slklim/ctm-battery-adapter/README.md

# ctm-battery-adapter
Hardware solution to replace two AAA batteries used to power a handheld CTM device
