slklim/ctm-battery-adapter/hardware/bom/ctm_battery_adapter-BOM_Amazon.xlsx

Line | Qty | Item | Description
1 | 10 | https://www.amazon.com/dp/B08T8TDS8S/ | Miady 2-Pack 5000mAh Mini Portable Charger
2 | 1 | https://www.amazon.com/dp/B018RSXR9C/ | uxcell M3 x 10mm Metric Hex Socket Countersunk Flat Head Screw Bolts 100PCS
