slklim/ctm-battery-adapter/hardware/bom/ctm_battery_adapter-BOM_DigiKey.xlsx

Index | Quantity | Part Number | Manufacturer Part Number | Description | Customer Reference
1 | 20 | 450-1660-ND | 1-1825027-7 | SWITCH TACTILE SPST-NO 0.05A 24V | SW1
2 | 20 | CSR0603FKR500CT-ND | CSR0603FKR500 | RES 0.5 OHM 1% 1/8W 0603 | R2
3 | 20 | 541-IHHP0805ZHER1R0M01CT-ND | IHHP0805ZHER1R0M01 | IHHP-0805ZH-01 1 20% ER E3 | L1
4 | 20 | 541-IHHP0805ZHER2R2M01CT-ND | IHHP0805ZHER2R2M01 | IHHP-0805ZH-01 2.2 20% ER E3 | L2
5 | 20 | A9AAT-0205F-ND | A9AAT-0205F | FLEX CABLE - AFE02T/AF02/AFE02T | J3
6 | 20 | 36-180-ND | 180 | BATT CONT SPRING AAA 1CEL PC PIN
7 | 20 | 36-179-ND | 179 | BATT CONT SPRING AAA 1CEL PC PIN
