slklim/ctm-battery-adapter/hardware/bom/ctm_battery_adapter-BOM_JLCSMT.xlsx

Comment | Designator | Footprint | JLCPCB Part #（optional）
DO NOT POPULATE | U1 | DO NOT POPULATE | DO NOT POPULATE
AP63203WU-7 | U2 | TSOT-23-6 | C780769
RT9080-30GJ5 | U3 | TSOT-23-5 | C965900
BL-HZ337A-L6-TRB | D1,D2,D3,D4 | 0402 | C189305
4.7K | R1,R2 | 0402 | C25900
10K | R3 | 0402 | C25744
DO NOT POPULATE | R4 | DO NOT POPULATE | DO NOT POPULATE
22u | C1,C4,C5,C7 | 0603 | C86295
10u | C2,C3,C6 | 0603 | C19702
1u | C8 | 0603 | C15849
100n | C9 | 0402 | C1525
DO NOT POPULATE | L1,L2 | DO NOT POPULATE | DO NOT POPULATE
10118192-0002LF | J1 | SMD USB MICRO B FEMALE | C2972784
DO NOT POPULATE | J2,J3 | DO NOT POPULATE | DO NOT POPULATE
DO NOT POPULATE | SW1 | DO NOT POPULATE | DO NOT POPULATE
