slklim/ctm-battery-adapter/enclosure/renderings/AaaBatteryLidArray.stl

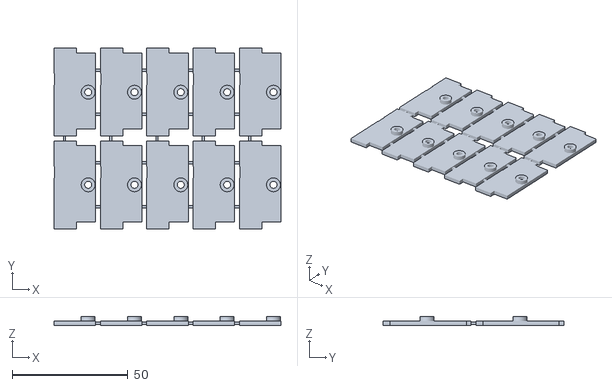
[picture p1: CAD file, 2024-01-05]
enclosure/renderings/AaaBatteryLidArray.stl
98.0 x 78.0 x 4.00
