slklim/ctm-battery-adapter/enclosure/renderings/AaaBatteryLid.stl

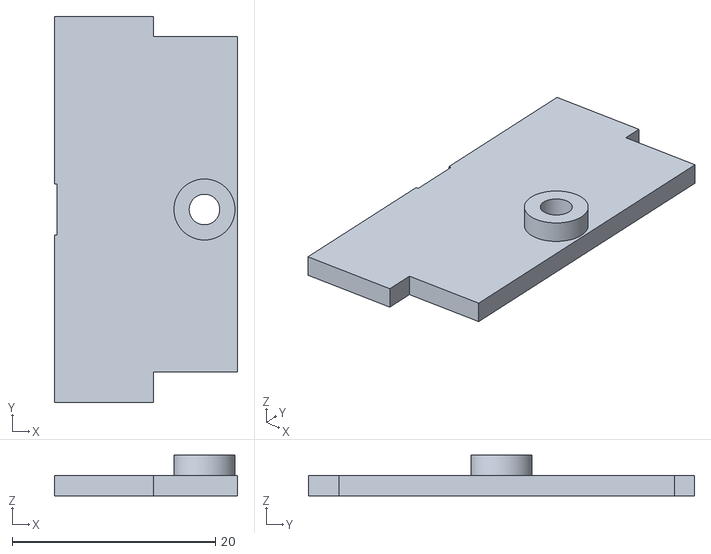
[picture p2: CAD file, 2024-01-05]
enclosure/renderings/AaaBatteryLid.stl
18.0 x 38.0 x 4.00
