slklim/ctm-battery-adapter/enclosure/renderings/AaaBatteryPair.stl

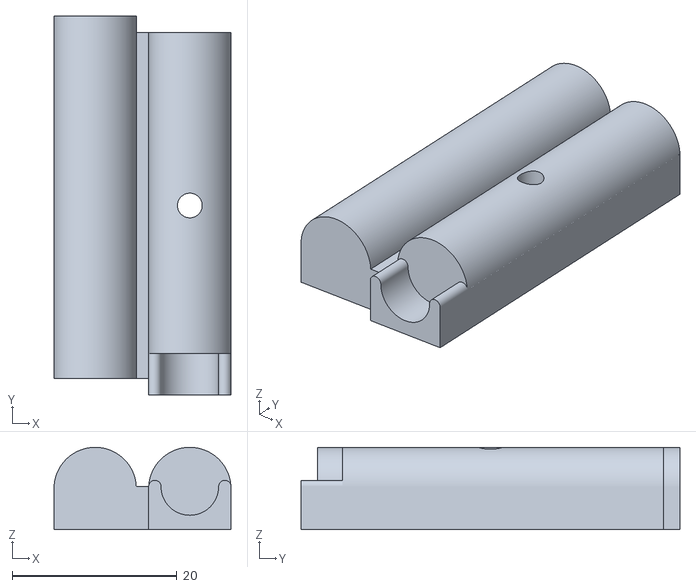
[picture p3: CAD file, 2024-01-05]
enclosure/renderings/AaaBatteryPair.stl
21.5 x 46.0 x 10.0
