slklim/ctm-battery-adapter/hardware/ctm_battery_adapter.kicad_pcb

## KiCad design hardware/ctm_battery_adapter.kicad_pcb (2023-03-18)

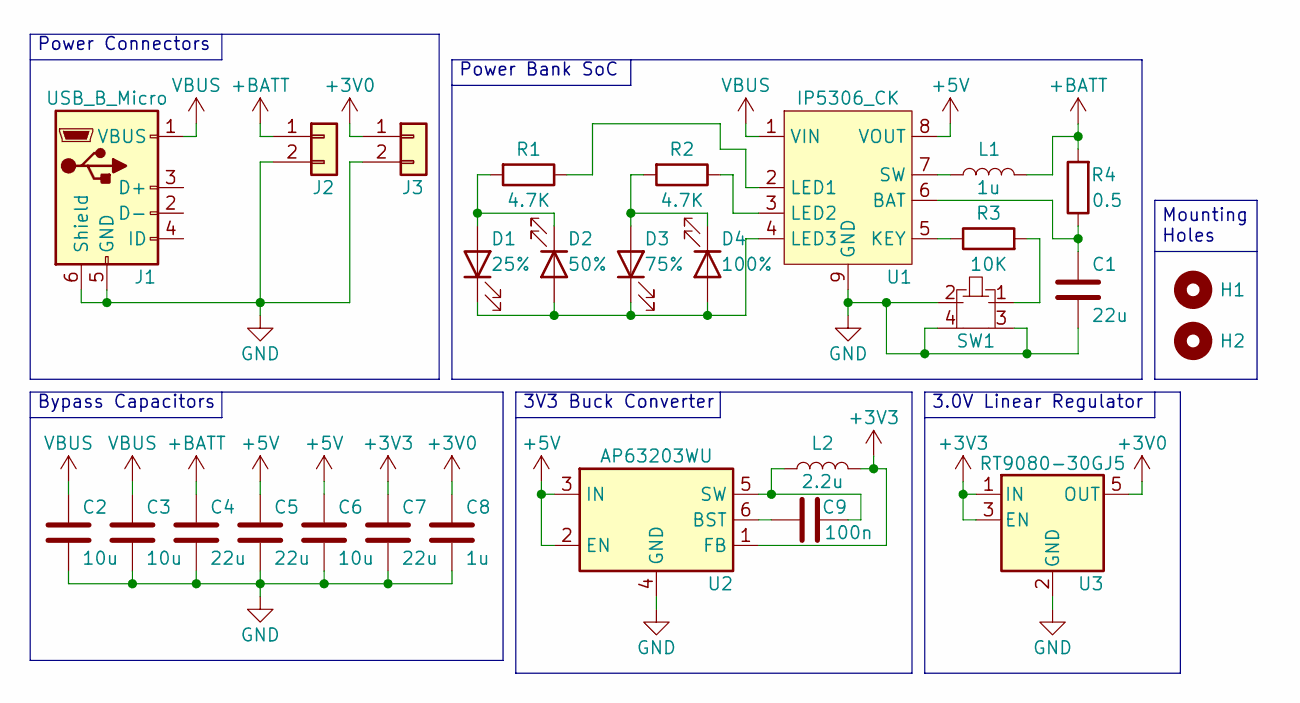
[picture p4: schematic ctm_battery_adapter.kicad_sch, CTM Battery]

Parts:
C1, C4, C5, C7: 22u; C_0603_1608Metric
C2, C3, C6: 10u; C_0603_1608Metric
C8: 1u; C_0603_1608Metric
C9: 100n; C_0402_1005Metric
D1: 25%; LED_0402
D2: 50%; LED_0402
D3: 75%; LED_0402
D4: 100%; LED_0402
H1, H2: MountingHole; MountingHole_3.2mm_M3
J1: USB_B_Micro; USB_Micro-B_Amphenol_10118192_Horizontal
J2, J3: Conn_01x02; PinHeader_1x02_P2.54mm_Vertical
L1: 1u; L_Vishay_IHHP_0806ZH
L2: 2.2u; L_Vishay_IHHP_0806ZH
R1, R2: 4.7K; R_0402_1005Metric
R3: 10K; R_0402_1005Metric
R4: 0.5; R_0603_1608Metric
SW1: SW_Push_SPST_Shielded; SW_Tactile_SKHH_Angled_Shielded
U1: IP5306_CK; eSOP-8
U2: AP63203WU; TSOT-23-6
U3: RT9080-30GJ5; TSOT-23-5

Connections:
+3V0: C8.1, J3.1, U3.5 (OUT)
+3V3: C7.1, L2.2, U2.1 (FB), U3.1 (IN), U3.3 (EN)
+5V: C5.1, C6.1, U1.8 (VOUT), U2.2 (EN), U2.3 (IN)
+BATT: C4.1, J2.1, L1.2, R4.2
GND: C1.2, C2.2, C3.2, C4.2, C5.2, C6.2, C7.2, C8.2, J1.5 (GND), J1.6 (Shield), J2.2, J3.2, SW1.2 (B), SW1.3 (SH1), SW1.4 (SH2), U1.9 (GND), U2.4 (GND), U3.2 (GND)
unnamed: D1.2 (A), D2.1 (K), R1.2
unnamed: D1.1 (K), D2.2 (A), D3.1 (K), D4.2 (A), U1.4 (LED3)
unnamed: D3.2 (A), D4.1 (K), R2.2
unnamed: R3.2, SW1.1 (A)
unnamed: C1.1, R4.1, U1.6 (BAT)
unnamed: R3.1, U1.5 (KEY)
unnamed: R1.1, U1.2 (LED1)
unnamed: R2.1, U1.3 (LED2)
unnamed: L1.1, U1.7 (SW)
unnamed: C9.1, U2.6 (BST)
unnamed: C9.2, L2.1, U2.5 (SW)
VBUS: C2.1, C3.1, J1.1 (VBUS), U1.1 (VIN)

Notes on the sheet:
Bypass Capacitors
Mounting Holes
Power Bank SoC
Power Connectors
3.0V Linear Regulator
3V3 Buck Converter

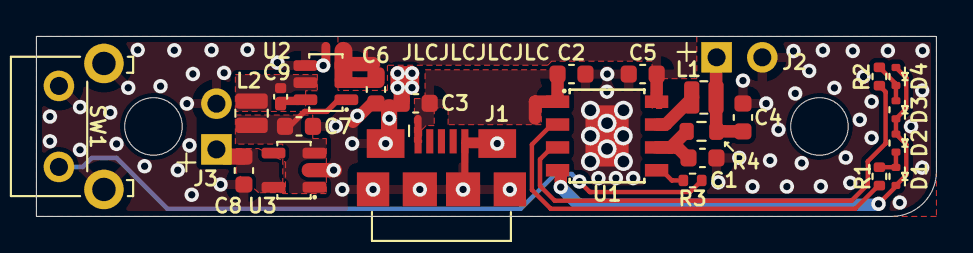
[picture p5: board ctm_battery_adapter.kicad_pcb from above]

Board: 2 copper layers, 50.0 x 10.0 mm, 28 parts (0 on the bottom side), 17 nets.
